supermileage/URBAN_BMS_HELPER/Urban Battery - BMS_complement.kicad_pcb

## KiCad design Urban Battery - BMS_complement.kicad_pcb (2024-10-12)

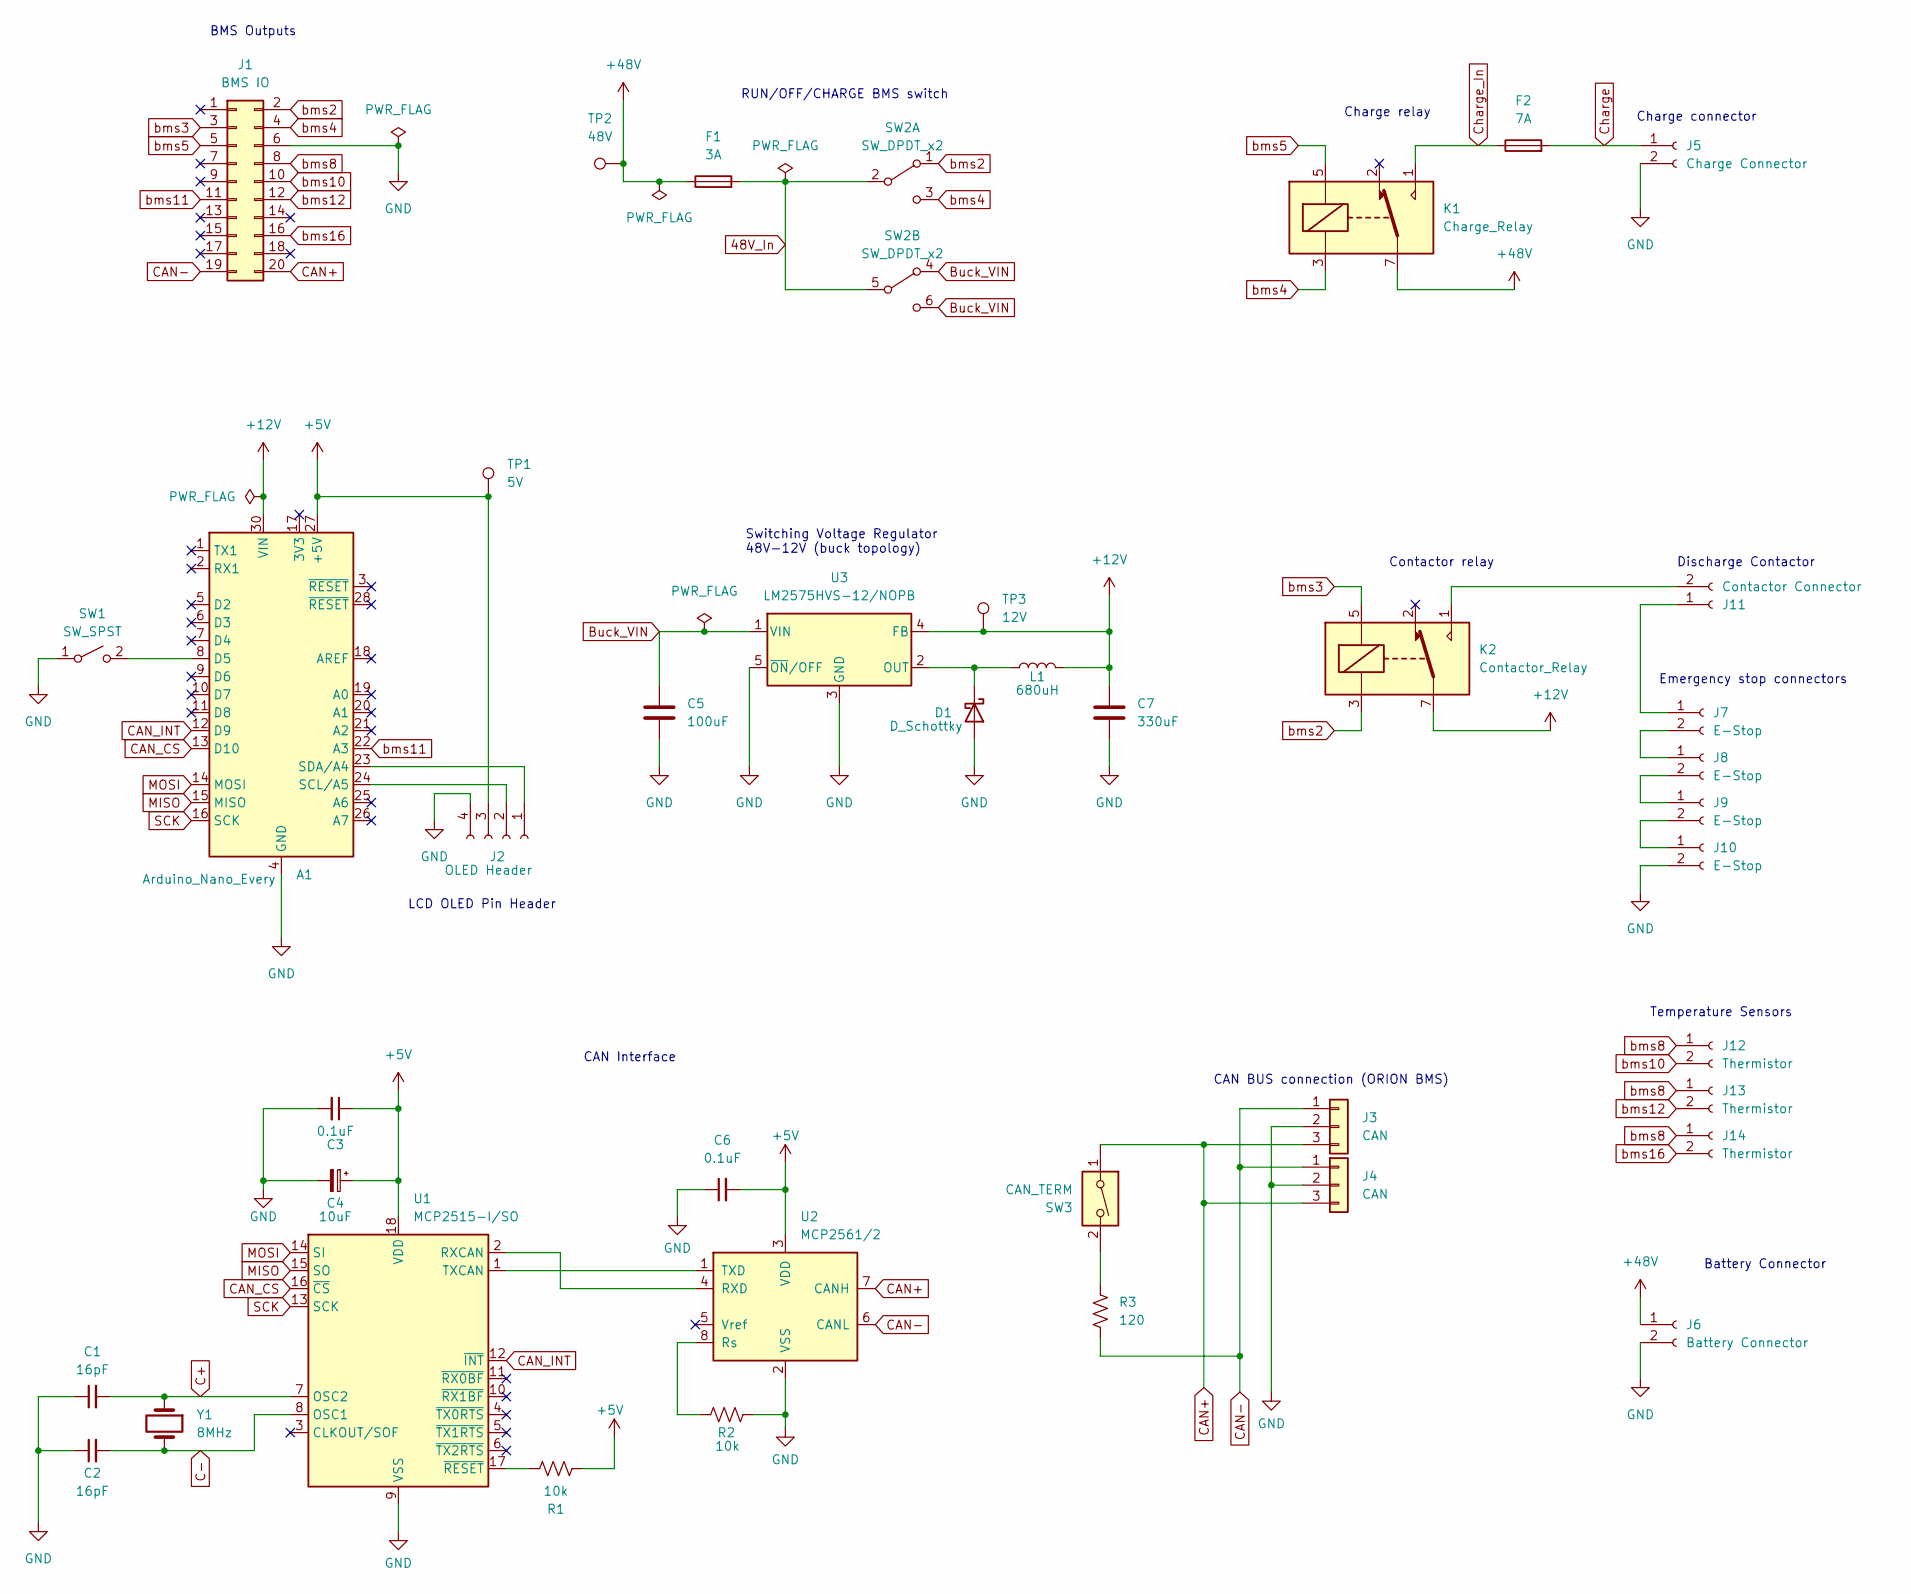
[picture p1: schematic Urban Battery - BMS_complement.kicad_sch]

Parts:
A1: Arduino_Nano_Every; Arduino_Nano
C1, C2: 16pF; C_0805_2012Metric_Pad1.18x1.45mm_HandSolder
C3, C6: 0.1uF; C_0805_2012Metric_Pad1.18x1.45mm_HandSolder
C4: 10uF; CP_Radial_D10.0mm_P5.00mm
C5: 100uF; CP_Radial_D12.5mm_P5.00mm
C7: 330uF; CP_Elec_10x10.5
D1: D_Schottky; D_DO-41_SOD81_P7.62mm_Horizontal
F1: 3A; Fuseholder_Blade_Mini_Keystone_3568
F2: 7A; Fuseholder_Blade_Mini_Keystone_3568
J1: BMS IO; B20BPADSS1FLFSN
J2: OLED Header; OLED_Header
J3, J4: CAN; molex-sl-1x03-horizontal
J5: Charge Connector; Molex_Mini-Fit_Jr_5569-02A2_2x01_P4.20mm_Horizontal
J6: Battery Connector; TerminalBlock_Phoenix_MKDS-1,5-2-5.08_1x02_P5.08mm_Horizont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
J7, J8, J9, J10: E-Stop; Molex_Micro-Fit_3.0_43650-0200_1x02_P3.00mm_Horizontal
J11: Contactor Connector; TerminalBlock_Phoenix_MKDS-1,5-2-5.08_1x02_P5.08mm_Horizont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
J12, J13, J14: Thermistor; TerminalBlock_Phoenix_MKDS-1,5-2-5.08_1x02_P5.08mm_Horizont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
K1: Charge_Relay; Relay_RT334048
K2: Contactor_Relay; Relay_RT334048
L1: 680uH; Inductor_PE-52629NL
R1, R2: 10k; R_0805_2012Metric_Pad1.20x1.40mm_HandSolder
R3: 120; R_0805_2012Metric_Pad1.20x1.40mm_HandSolder
SW1: SW_SPST; SW_Tactile_SPST_Angled_PTS645Vx31-2LFS
SW2: SW_DPDT_x2; Toggle_Switch_M2022S2A2W30
SW3: CAN_TERM; PinHeader_1x02_P2.54mm_Horizontal
TP1: 5V; TestPoint_Pad_2.0x2.0mm
TP2: 48V; TestPoint_Pad_2.0x2.0mm
TP3: 12V; TestPoint_Pad_2.0x2.0mm
U1: MCP2515-I/SO; SOIC-18W_7.5x11.6mm_P1.27mm
U2: MCP2561/2; SOIC-8_3.9x4.9mm_P1.27mm
U3: LM2575HVS-12/NOPB; TO-263-5_TabPin3
Y1: 8MHz; Crystal_HC49-U_Vertical

Connections:
48V_In: F1.2, SW2.2 (B), SW2.5 (B)
+5V: A1.27 (+5V), C3.1, C4.1, C6.2, J2.3, R1.1, TP1.1, U1.18 (VDD), U2.3 (VDD)
+12V: A1.30 (VIN), C7.1, K2.7, L1.2, TP3.1, U3.4 (FB)
+48V: F1.1, J6.1, K1.7, TP2.1
Buck_VIN: C5.1, SW2.4 (A), SW2.6 (C), U3.1 (VIN)
C+: C1.2, U1.7 (OSC2), Y1.1
C-: C2.2, U1.8 (OSC1), Y1.2
CAN+: J1.20, J3.3, J4.3, SW3.1, U2.7 (CANH)
CAN-: J1.19, J3.1, J4.1, R3.2, U2.6 (CANL)
CAN_CS: A1.13 (D10), U1.16 (~CS)
CAN_INT: A1.12 (D9), U1.12 (~INT)
Charge: F2.2, J5.1
Charge_In: F2.1, K1.1
GND: A1.4 (GND), A1.29 (GND), C1.1, C2.1, C3.2, C4.2, C5.2, C6.1, C7.2, D1.2 (A), J1.6, J2.4, J3.2, J4.2, J5.2, J6.2, J10.2, R2.2, SW1.1 (A), U1.9 (VSS), U2.2 (VSS), U3.3 (GND), U3.5 (~ON/OFF)
MISO: A1.15 (MISO), U1.15 (SO)
MOSI: A1.14 (MOSI), U1.14 (SI)
unnamed: A1.8 (D5), SW1.2 (B)
unnamed: A1.23 (SDA/A4), J2.1
unnamed: A1.24 (SCL/A5), J2.2
unnamed: D1.1 (K), L1.1, U3.2 (OUT)
unnamed: J7.2, J8.1
unnamed: J8.2, J9.1
unnamed: J9.2, J10.1
unnamed: J7.1, J11.1
unnamed: J11.2, K2.1
unnamed: R1.2, U1.17 (~RESET)
unnamed: R2.1, U2.8 (Rs)
unnamed: R3.1, SW3.2
unnamed: U1.1 (TXCAN), U2.1 (TXD)
unnamed: U1.2 (RXCAN), U2.4 (RXD)
SCK: A1.16 (SCK), U1.13 (SCK)
bms2: J1.2, K2.3, SW2.1 (A)
bms3: J1.3, K2.5
bms4: J1.4, K1.3, SW2.3 (C)
bms5: J1.5, K1.5
bms8: J1.8, J12.1, J13.1, J14.1
bms10: J1.10, J12.2
bms11: A1.22 (A3), J1.11
bms12: J1.12, J13.2
bms16: J1.16, J14.2

Notes on the sheet:
Charge connector
Contactor relay
Temperature Sensors
Switching Voltage Regulator 48V-12V (buck topology)
Charge relay
RUN/OFF/CHARGE BMS switch
BMS Outputs
CAN BUS connection (ORION BMS)
Emergency stop connectors
Battery Connector
LCD OLED Pin Header
Discharge Contactor
CAN Interface

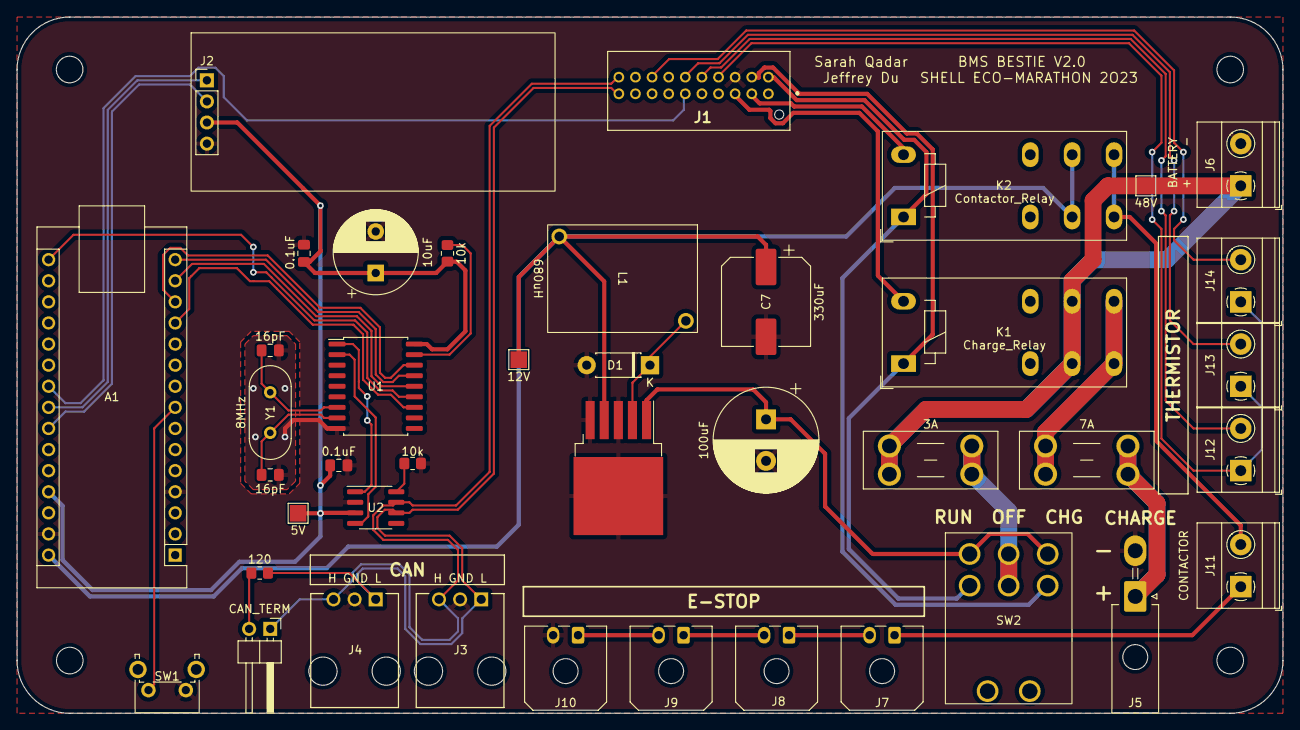
[picture p2: board Urban Battery - BMS_complement.kicad_pcb from above]

Board: 2 copper layers, 152.4 x 83.8 mm, 41 parts (0 on the bottom side), 40 nets.
