supermileage/URBAN_BMS_HELPER/(commit log)

2022-10-22 Started PCB schematic
    [Urban Battery - BMS_complement.kicad_pcb, Urban Battery - BMS_complement.kicad_sch]
2022-10-22 generic schematic created
    [Urban Battery - BMS_complement.kicad_sch]
2022-10-29 Added to schematic and assigned some footprints
    [Urban Battery - BMS_complement.kicad_sch]
2022-11-05 Schematic updates and added custom footprint library
    [Urban Battery - BMS_complement.kicad_sch]
2022-11-06 CAN interface added, fixed all electrical errors, added some footprints
    [Urban Battery - BMS_complement.kicad_sch]
2022-11-08 added pushbutton and OLED LCD circuit to arduino
2022-11-10 Added temporary footprints and preliminary layout
    [Urban Battery - BMS_complement.kicad_pcb, Urban Battery - BMS_complement.kicad_sch]
2022-11-10 Edited component placement
    [Urban Battery - BMS_complement.kicad_pcb, Urban Battery - BMS_complement.kicad_sch]
2022-11-11 reorganized layout, started routing traces and added supermileage logo
    [Urban Battery - BMS_complement.kicad_pcb, Urban Battery - BMS_complement.kicad_sch]
2022-11-12 added can_int, changed oled button, added 4th safety switch
    [Urban Battery - BMS_complement.kicad_sch]
2022-11-12 updated layout from schematic, deleted traces
    [Urban Battery - BMS_complement.kicad_pcb, Urban Battery - BMS_complement.kicad_sch]
2022-11-13 First layout complete
    [Urban Battery - BMS_complement.kicad_pcb, Urban Battery - BMS_complement.kicad_sch]
2022-11-14 Layout updated
    [Urban Battery - BMS_complement.kicad_pcb, Urban Battery - BMS_complement.kicad_sch]
2022-11-14 moved supermileage logo
    [Urban Battery - BMS_complement.kicad_pcb]
2022-11-16 Updated traces
    [Urban Battery - BMS_complement.kicad_pcb]
2022-11-25 switched 12V charge and contactor relays for 48V relays, updated symbol and footprint accordingly
    [Urban Battery - BMS_complement.kicad_sch]
2022-11-26 Updated components and layout
    [Urban Battery - BMS_complement.kicad_pcb, Urban Battery - BMS_complement.kicad_sch]
2022-11-26 updated schematic, added new footprints etc
    [Urban Battery - BMS_complement.kicad_sch]
2022-11-28 specced R1, R2, C3, C6 and R3, updated schematic with their datasheets
    [Urban Battery - BMS_complement.kicad_sch]
2022-12-03 Reassigned inductor footprint
    [Urban Battery - BMS_complement.kicad_pcb, Urban Battery - BMS_complement.kicad_sch]
2022-12-03 fixed relay symbols
    [Urban Battery - BMS_complement.kicad_sch]
2022-12-04 Updated C4, added differential pairs to CAN
    [Urban Battery - BMS_complement.kicad_pcb, Urban Battery - BMS_complement.kicad_sch]
2022-12-14 Updated silkscreen, added test points
    [Urban Battery - BMS_complement.kicad_pcb, Urban Battery - BMS_complement.kicad_sch]
2022-12-25 updated component datasheets
    [Urban Battery - BMS_complement.kicad_sch]
2022-12-26 Updated relays & silkscreen
    [Urban Battery - BMS_complement.kicad_pcb, Urban Battery - BMS_complement.kicad_sch]
2022-12-30 generated gerbers
    [Urban Battery - BMS_complement-B_Cu.gbl, Urban Battery - BMS_complement-B_Mask.gbs, Urban Battery - BMS_complement-B_Paste.gbp, Urban Battery - BMS_complement-B_Silkscreen.gbo, Urban Battery - BMS_complement-Edge_Cuts.gm1, Urban Battery - BMS_complement-F_Cu.gtl, Urban Battery - BMS_complement-F_Mask.gts, Urban Battery - BMS_complement-F_Paste.gtp]
2023-01-01 added datasheets for tactile switch and OLED header
    [Urban Battery - BMS_complement.kicad_sch]
2023-02-27 swapped run and charge labels, changed charge connector, renamed board
    [Urban Battery - BMS_complement.kicad_pcb, Urban Battery - BMS_complement.kicad_sch]
2023-03-02 added downloaded footprint for bms i/o, updated on layout. fixed orientation of charge connector labels
    [Urban Battery - BMS_complement.kicad_pcb, Urban Battery - BMS_complement.kicad_sch]
2023-03-03 fixed errors brought up by DRC on pcb
    [Urban Battery - BMS_complement.kicad_pcb]
2023-03-04 generated gerbers and drill file in gerbers2.0
    [Urban Battery - BMS_complement-B_Cu.gbl, Urban Battery - BMS_complement-B_Mask.gbs, Urban Battery - BMS_complement-B_Paste.gbp, Urban Battery - BMS_complement-B_Silkscreen.gbo, Urban Battery - BMS_complement-Edge_Cuts.gm1, Urban Battery - BMS_complement-F_Cu.gtl, Urban Battery - BMS_complement-F_Mask.gts, Urban Battery - BMS_complement-F_Paste.gtp]
2024-10-12 only pushing to verify no accidental changes were made before more people work on this again
    [Urban Battery - BMS_complement.kicad_pcb, Urban Battery - BMS_complement.kicad_sch]
2024-10-16 updated connector footprints of J6 and J12-J14
    [Urban Battery - BMS_complement.kicad_sch]
2024-10-16 updated J13, J14 footprints and datasheets to match J12
    [Urban Battery - BMS_complement.kicad_sch]
